nccgroup/TPMGenie/(threads)

Thread 1 (2018-03-15):

LPC Based Genie

jbdatko, 2018-03-15:
This isn't so much an issue as it is a suggestion, but github, /shrub.

On the LPC, I've considered taking this project as TPM Sniffer (https://github.com/lynxis/lpc_sniffer). The FPGA could be added to an Arduino Shield perhaps. But anyway, there's verilog changes that need to be made to inject LPC commands.

This was the closest starting point for LPC TPM hacking I could find, so maybe it triggers some other insight.

jeremyncc, 2018-03-16:
Whoa nice! I'm definitely gonna check this out.

Thread 4 (2019-08-05):

i2c_t3 multi-wire issue

buecheko, 2019-08-05:
It seems that the current i2c_t3 version is causing problems.

https://github.com/nox771/i2c_t3/issues/26
As you can see in this issue it is a known problem. If I got them right.

Maybe you could mention this somewhere and/or provide a working version of the library.
If I can get it running, I will update this issue and specify the latest working version here.

buecheko, 2019-08-06:
https://github.com/nox771/i2c_t3/commit/0a1b06111f9e16de20589a8c937fe7ef77089e99
This is probably the commit that leads to the problem. So any version before this should work for our purposes.

jeremyncc, 2019-08-06:
Thanks for tracking this down. I haven't used TPM Genie in a while, so I hadn't realized that i2c_t3 had become broken. I should have mentioned the version of the module I used when doing the initial research. Sorry for any inconvenience.

jeremyncc, 2021-01-04:
fixed in commit https://github.com/nccgroup/TPMGenie/commit/dd6dd2278dd3f49b25a15aaa1f15b6a737fb32b5

Closed 2021-01-04.

Thread 5 (2019-08-06):

Raspberry Pi 3B i2c hardware bug

buecheko, 2019-08-06:
Regarding the i2c hardware bug.
I use a Raspberry Pi 3B in my setup and tried to solve the issue as described in the known issue section. Unfortunately, that didn't help.

I still had the problem that sometimes the ACK coming from the PI was not recognized by the Teensy.
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

I the end I solved it by using the i2c_gpio bitbang kernel module instead of the hardware implementation.

To do so, I replaced
`dtparam=i2c_arm=on,i2c_arm_baudrate=100000`
by
`dtoverlay=i2c-gpio,i2c_gpio_sda=2,i2c_gpio_scl=3`
in the config file '/boot/config.txt'.

jeremyncc, 2019-08-06:
Nice!

Thread 6 (2019-08-06):

No tpm_rng kernel module in current kernel versions.

buecheko, 2019-08-06:
The tpm_rng kernel module was removed https://github.com/raspberrypi/linux/commit/6e592a065d51d26f9d62b8b7501a5114076af8b4.

To still use the TPM as hwrng device you need to change the value of '/sys/class/misc/hw_random/rng_current' to the desired value.
To do so:

1. Check if the TPM is available:
`# cat /sys/class/misc/hw_random/rng_available`
    The output should look like this:
`3f104000.rng tpm-rng-0`

2. Write the desired value to rng_current
`# echo tpm-rng-0 > /sys/class/misc/hw_random/rng_current`

For more information see https://github.com/raspberrypi/linux/blob/rpi-4.19.y/Documentation/hw_random.txt

PS: Sorry for spamming Issues. This will be the last one.  :)

jeremyncc, 2019-08-06:
The PoC that shows how TPMGenie can control the output of the hwrng was really done only for fun. In reality the TPM's RNG isn't tied into anything useful within the kernel, and was exposed to userspace for unknown reasons. In practice, anyone that wants random bytes from the TPM will probably use the API (issue the GetRandom cmd directly), rather than using the hwrng chardev.

Anyhow, nice work tracking down a solution!

Thread 7 (2020-08-25):

Update README to use old version of i2c_t3

nickylimjj, 2020-08-25:
In light of #4 , I think the README should be updated temporarily until #4 is resolved.

jeremyncc, 2021-01-04:
fixed in https://github.com/nccgroup/TPMGenie/commit/dd6dd2278dd3f49b25a15aaa1f15b6a737fb32b5

Closed 2021-01-04.

Thread 8 (2020-12-22):

TPM in Arduino

mikelga, 2020-12-22:
Hello!

Do you have experience using TPM with Arduino (with SPI interface)? I have read something that you were running some tests.
Have you gotten it to work?

Thank you!

jegHEEK73, 2020-12-22:
In my previous job/role at HP I did some work on TPM, but have since moved
on to another venture so unfortunately No I have not.
Good Luck with it!
Dave

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

jeremyncc, 2021-01-04:
Hi there,

I'm sorry to report that I haven't finished the TPM interposer for Arduino/SPI.

Jeremy
